ChrisE-UoN/PX4-Micro-Quad/PDB_ESC_BEC.png

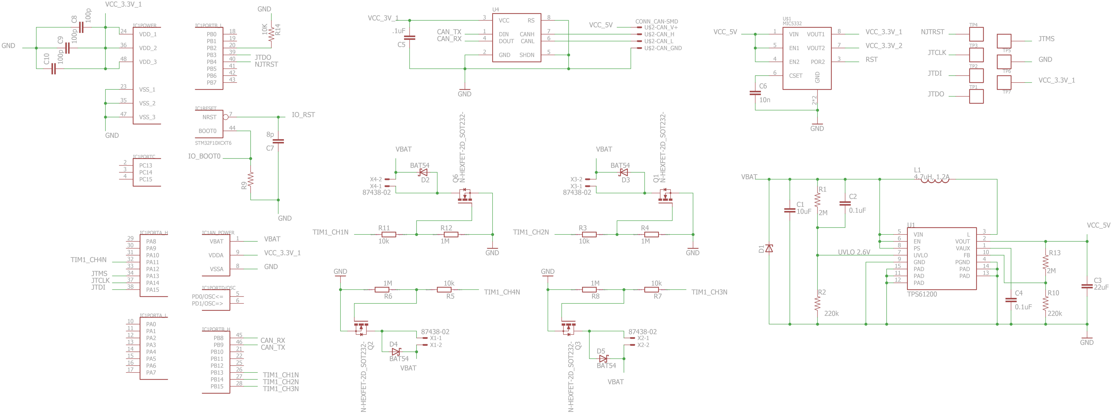
PDB_ESC_BEC.png
