ChrisE-UoN/PX4-Micro-Quad/PDB_ESC_BEC_Release.sch

## EAGLE design PDB_ESC_BEC_Release.sch (2016-03-13)

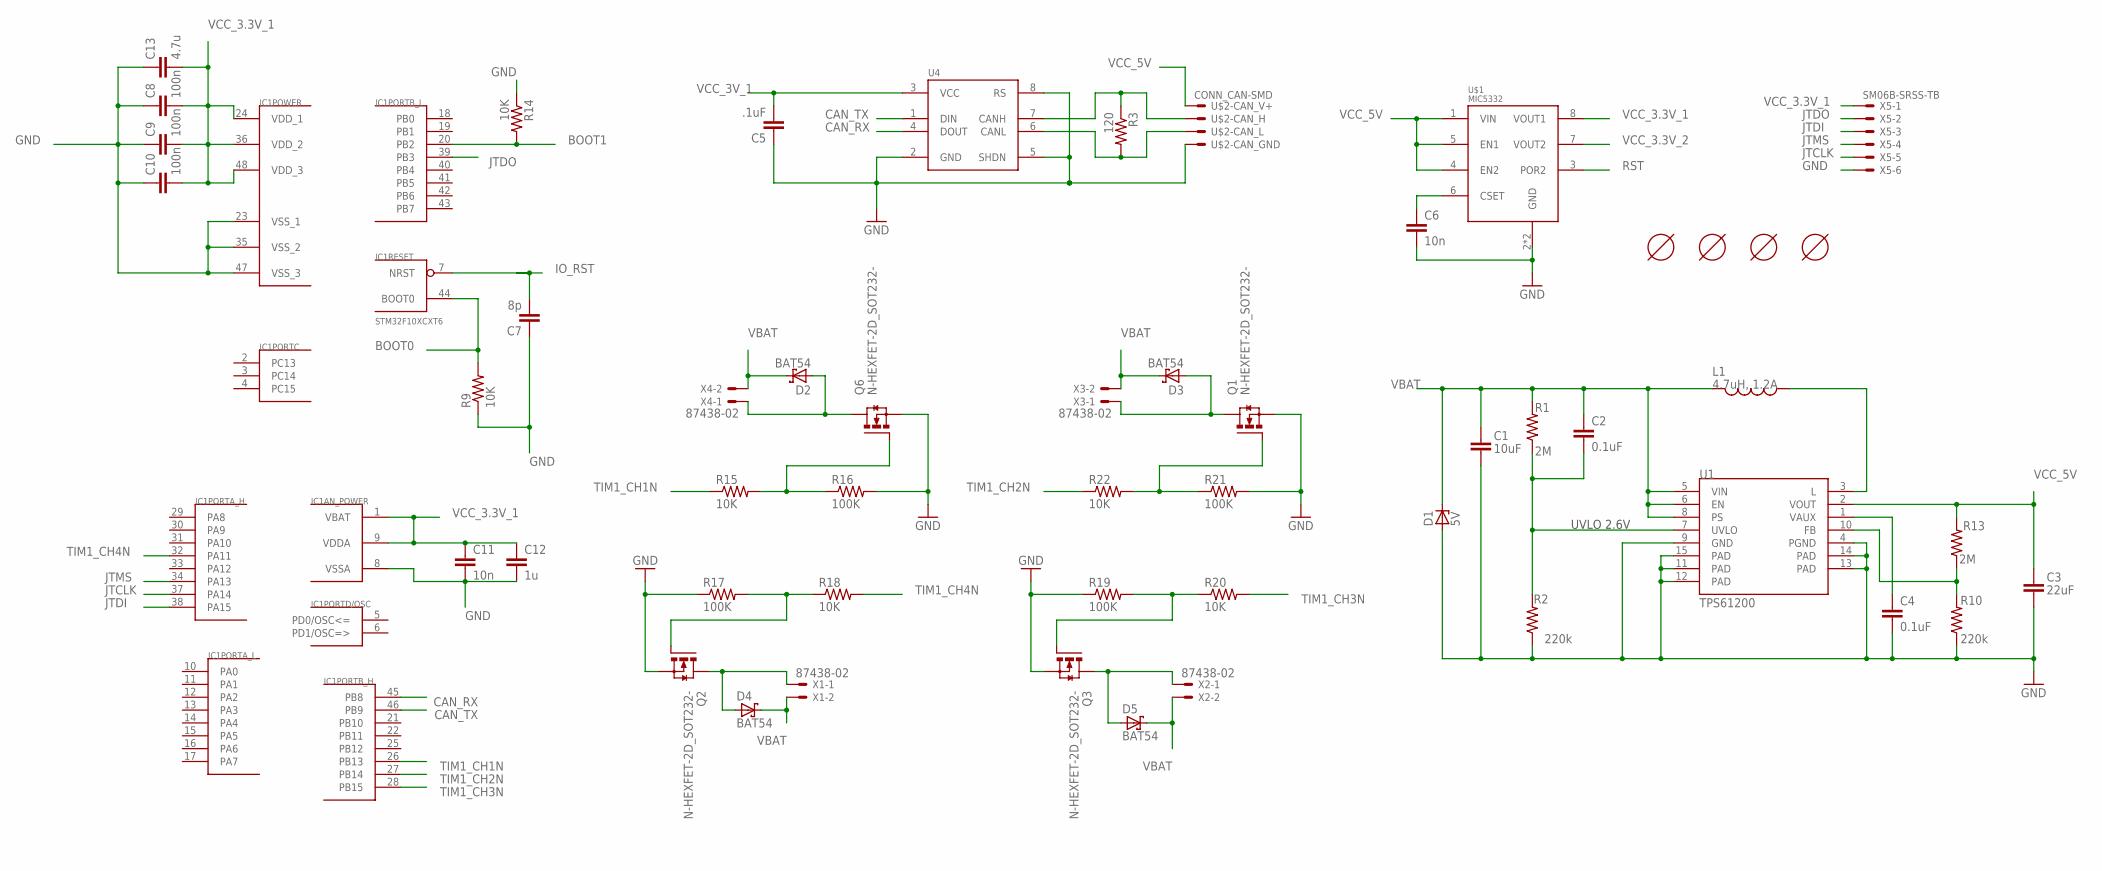
[picture p2: schematic PDB_ESC_BEC_Release.sch]

Parts:
C1: 10uF; 1206
C2, C4: 0.1uF; 0603-CAP
C3: 22uF; 0805
C5: .1uF; C1206
C6: 10n; 0603-CAP
C7: 8p; 1206-CAP
C8, C9, C10: 100n; 1206-CAP
C11: 10n; 1206-CAP
C12: 1u; 1206-CAP
C13: 4.7u; 1206-CAP
D1: 5V; F126Z10
D2, D3, D4, D5: BAT54; SOT23-3
IC1: STM32F10XCXT6; TQFP48
L1: 4.7uH, 1.2A; CDRH2D09
Q1, Q2, Q3, Q6: N-HEXFET-2D_SOT232-; SOT223
R1, R13: 2M; 0603-RES
R2, R10: 220k; 0603-RES
R3: 120; 1206
R9, R14, R15, R18, R20, R22: 10K; 1206
R16, R17, R19, R21: 100K; 1206
U1: TPS61200; QFN-10_PAD
U4: MAX3051MAX3051ESA; SO08
U$1: MIC5332; MLF-8-EPAD
U$2: CONN_CAN-SMD; S4B-PH-SM4-TB
U$3, U$4, U$5, U$6: MOUNT-HOLE3.1MM; MOUNT-HOLE3.1
X1, X2, X3, X4: 87438-02
X5: SM06B-SRSS-TB

Connections:
BOOT0: IC1.44 (BOOT0), R9.2
BOOT1: IC1.20 (PB2), R14.2
CAN_RX: IC1.45 (PB8), U4.4 (DOUT)
CAN_TX: IC1.46 (PB9), U4.1 (DIN)
FB: R10.2, R13.1, U1.10 (FB)
GND: C1.2, C3.2, C4.2, C5.1, C6.2, C7.P$1 (1), C8.P$1 (1), C9.P$1 (1), C10.P$1 (1), C11.P$2 (2), C12.P$2 (2), C13.P$1 (1), D1.A, IC1.8 (VSSA), IC1.23 (VSS_1), IC1.35 (VSS_2), IC1.47 (VSS_3), Q1.3 (S), Q2.3 (S), Q3.3 (S), Q6.3 (S), R2.1, R9.1, R10.1, R14.1, R16.2, R17.1, R19.1, R21.2, U1.4 (PGND), U1.9 (GND), U1.11 (PAD), U1.12 (PAD), U1.13 (PAD), U1.14 (PAD), U1.15 (PAD), U4.2 (GND), U4.5 (SHDN), U4.8 (RS), U$1.2 (GND), U$2.4, X5.6
IO_RST: C7.P$2 (2), IC1.7 (NRST)
JTCLK: IC1.37 (PA14), X5.5
JTDI: IC1.38 (PA15), X5.3
JTDO: IC1.39 (PB3), X5.2
JTMS: IC1.34 (PA13), X5.4
unnamed: L1.P$1 (1), U1.3 (L)
unnamed: D2.1 (A), Q6.2 (D), X4.1
unnamed: Q1.1 (G), R21.1, R22.2
unnamed: D3.1 (A), Q1.2 (D), X3.1
unnamed: Q2.1 (G), R17.2, R18.1
unnamed: Q6.1 (G), R15.2, R16.1
unnamed: D4.1 (A), Q2.2 (D), X1.1
unnamed: Q3.1 (G), R19.2, R20.1
unnamed: D5.1 (A), Q3.2 (D), X2.1
unnamed: R3.2, U4.6 (CANL), U$2.3
unnamed: C4.1, U1.1 (VAUX)
unnamed: R3.1, U4.7 (CANH), U$2.2
unnamed: C6.1, U$1.6 (CSET)
RST: U$1.3 (POR2)
TIM1_CH1N: IC1.26 (PB13), R15.1
TIM1_CH2N: IC1.27 (PB14), R22.1
TIM1_CH3N: IC1.28 (PB15), R20.2
TIM1_CH4N: IC1.32 (PA11), R18.2
UVLO: C2.2, R1.1, R2.2, U1.7 (UVLO)
VBAT: C1.1, C2.1, D1.C, D2.3 (C), D3.3 (C), D4.3 (C), D5.3 (C), L1.P$2 (2), R1.2, U1.5 (VIN), U1.6 (EN), U1.8 (PS), X1.2, X2.2, X3.2, X4.2
VCC_3.3V_1: C8.P$2 (2), C9.P$2 (2), C10.P$2 (2), C11.P$1 (1), C12.P$1 (1), C13.P$2 (2), IC1.1 (VBAT), IC1.9 (VDDA), IC1.24 (VDD_1), IC1.36 (VDD_2), IC1.48 (VDD_3), U$1.8 (VOUT1), X5.1
VCC_3.3V_2: U$1.7 (VOUT2)
VCC_3V_1: C5.2, U4.3 (VCC)
VCC_5V: C3.1, R13.2, U1.2 (VOUT), U$1.1 (VIN), U$1.4 (EN2), U$1.5 (EN1), U$2.1

Notes on the sheet:
UVLO 2.6V
