ChrisE-UoN/PX4-Micro-Quad/(commit log)

2016-03-06 Added files via upload
    Schematics for a combination Power Distribution Board, brushed Electronic Speed Controller, and Battery Elimination Circuit.
    [PDB.ESC.BEC.sch]
2016-04-01 Revision 2
    PCB redesigned in Altium.
    * Dropped boost converter
    * PCB now requires 7.4v (2s lipo) supply
2016-04-01 Updated for new board design.
2016-06-09 Add files via upload
    Can bus test code for STM32F103C8T6
